UBCOAerospaceClub/LTELink/KiCad/LTELink/images/back-perspective.png

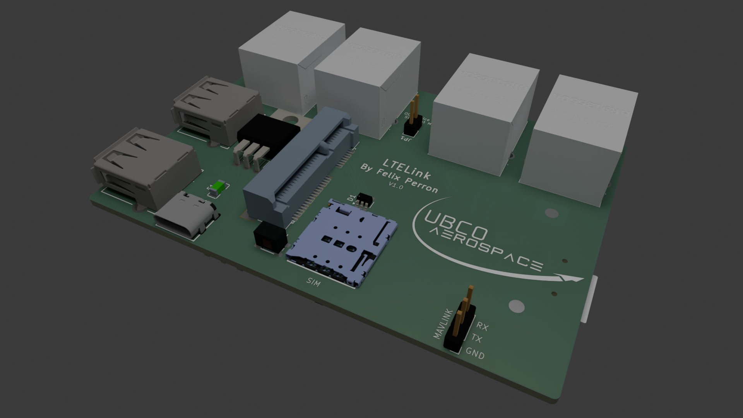
KiCad/LTELink/images/back-perspective.png
