UBCOAerospaceClub/LTELink/KiCad/LTELink/images/back.png

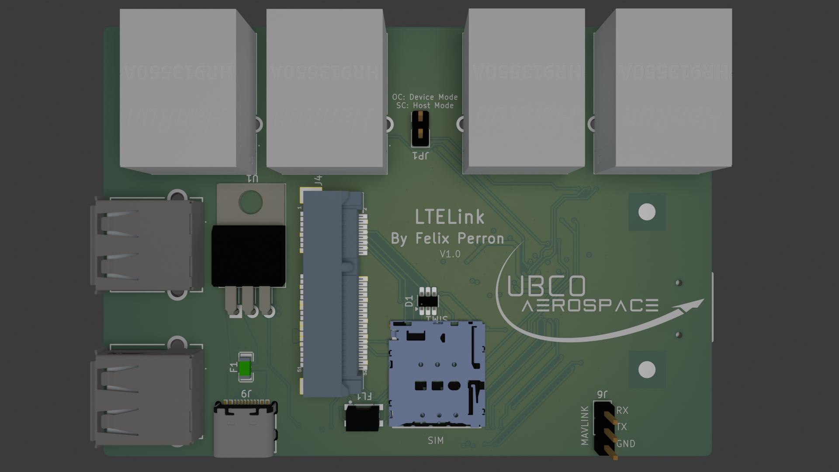
KiCad/LTELink/images/back.png
