UBCOAerospaceClub/LTELink/KiCad/LTELink/images/front-perspective.png

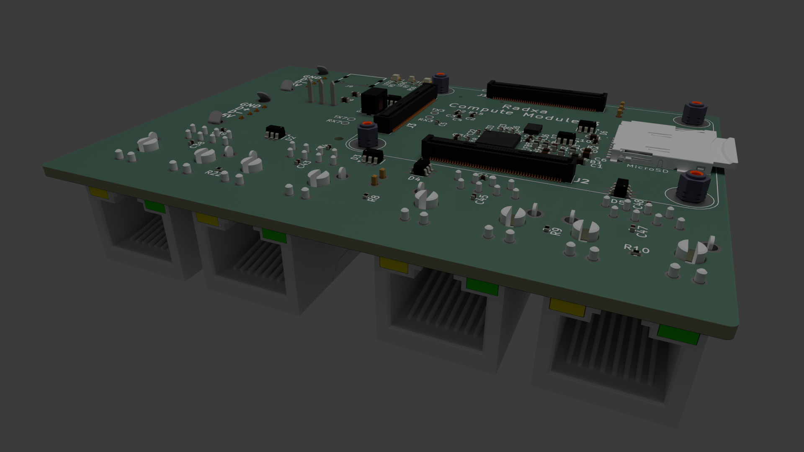
KiCad/LTELink/images/front-perspective.png
