UBCOAerospaceClub/LTELink/KiCad/LTELink/images/front.png

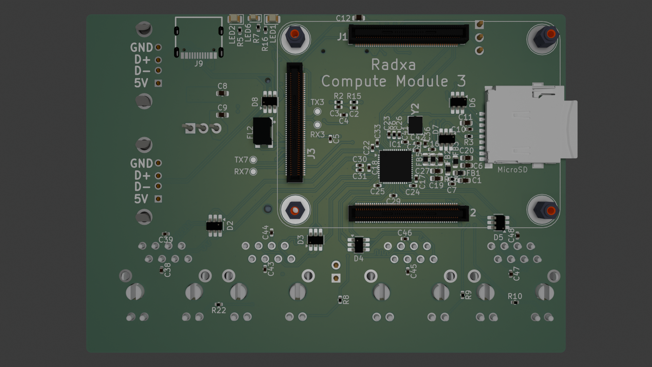
KiCad/LTELink/images/front.png
