UBCOAerospaceClub/LTELink/KiCad/LTELink/images/ports.png

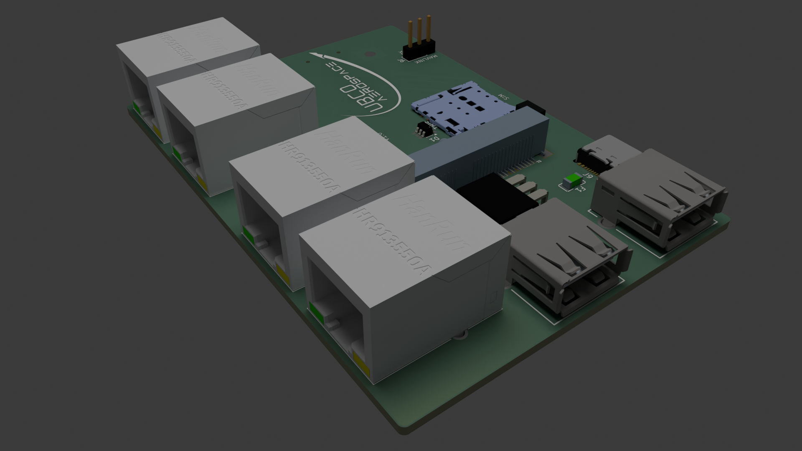
KiCad/LTELink/images/ports.png
