UBCOAerospaceClub/LTELink/KiCad/USB Breakout/production/bom.csv

Designator | Footprint | Quantity | Value | LCSC Part #
J1 | 902131A1011D10100 | 1 | USB_A
J2 | PinHeader_1x04_P2.54mm_Vertical | 1 | Conn_01x04
