UBCOAerospaceClub/LTELink/KiCad/Ethernet Breakout/production/bom.csv

Designator | Footprint | Quantity | Value | LCSC Part #
C2, C3 | 0603 | 2 | 100n | C1525
