UBCOAerospaceClub/LTELink/(list of files, cad)

Other CAD files:
KiCad/LTELink/LTELink.blend
