UBCOAerospaceClub/LTELink/KiCad/Ethernet Breakout/Ethernet Breakout.kicad_pcb

## KiCad design KiCad/Ethernet Breakout/Ethernet Breakout.kicad_pcb (2026-06-09)

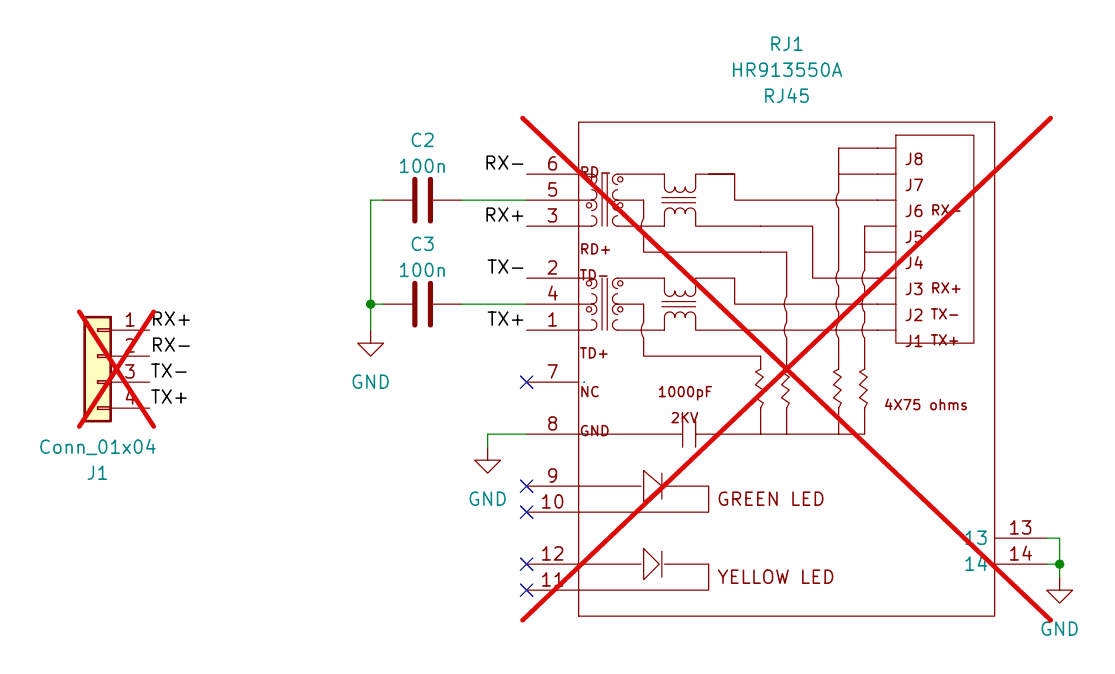
[picture p6: schematic Ethernet Breakout.kicad_sch]

Parts:
C2, C3: 100n; C_0603_1608Metric_Pad1.08x0.95mm_HandSolder; LCSC Part # C1525
J1: Conn_01x04; PinHeader_1x04_P2.54mm_Vertical; not fitted
RJ1: HR913550A; not fitted

Connections:
/RX+: J1.1, RJ1.3
/RX-: J1.2, RJ1.6
/TX+: J1.4, RJ1.1
/TX-: J1.3, RJ1.2
GND: C2.1, C3.1, RJ1.8 (GND), RJ1.13, RJ1.14
unnamed: C2.2, RJ1.5
unnamed: C3.2, RJ1.4

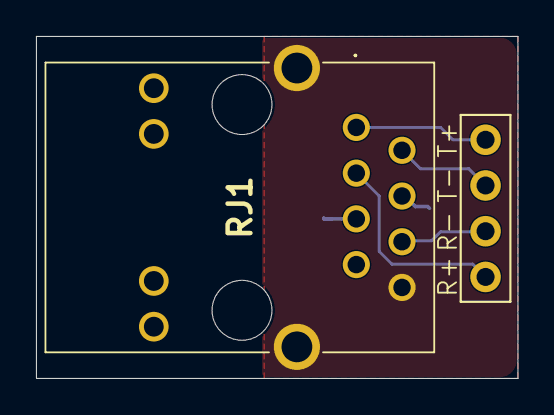
[picture p7: board Ethernet Breakout.kicad_pcb from above]

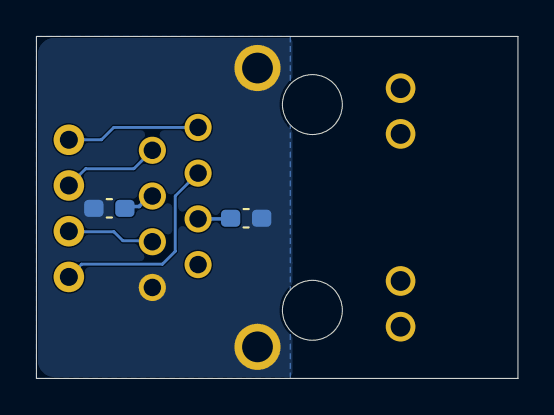
[picture p8: board Ethernet Breakout.kicad_pcb from below]

Board: 2 copper layers, 26.8 x 19.0 mm, 4 parts (2 on the bottom side), 7 nets.
