UBCOAerospaceClub/LTELink/(commit log)

2026-01-07 update current state of project
    [EC25.kicad_sch, LTELink.kicad_sch, compute_module.kicad_sch, ethernet.kicad_sch, sd_card.kicad_sch, uart.kicad_sch, usb.kicad_sch]
2026-01-22 mostly done except for RTL8305 power stuff
    [EC25.kicad_sch, LTELink.kicad_sch, ethernet.kicad_sch, sd_card.kicad_sch, usb.kicad_sch]
2026-01-24 most traces complete. need to connect grounds
    [ethernet.kicad_sch]
2026-01-25 Wiring complete!
2026-01-29 Finally done the layout
    [LTELink.kicad_sch, uart.kicad_sch, usb.kicad_sch]
2026-02-04 Finalized layout, added more detailed 3d models
    [LTELink.blend, LTELink.kicad_pcb, uart.kicad_sch]
2026-02-06 replaced ferrites with 0 omh resitors, finalized standoff solution
    [EC25.kicad_sch, LTELink.kicad_pcb, compute_module.kicad_sch, ethernet.kicad_sch, sd_card.kicad_sch]
2026-02-06 fix ethernet skews
    [LTELink.kicad_pcb]
2026-02-07 finalized board for fabrication
    [EC25.kicad_sch, LTELink.kicad_pcb, LTELink_bom.csv, LTELink_designators.csv, LTELink_positions.csv, compute_module.kicad_sch, ethernet.kicad_sch, sd_card.kicad_sch]
2026-02-11 fix incorrect footprint orientation and breakout uarts
    [EC25.kicad_sch, LTELink.kicad_pcb, LTELink.kicad_sch, compute_module.kicad_sch, uart.kicad_sch, usb.kicad_sch]
2026-03-29 fixed CM3 footprint
    [EC25.kicad_sch, LTELink.kicad_pcb, LTELink.kicad_sch, compute_module.kicad_sch, ethernet.kicad_sch, sd_card.kicad_sch, uart.kicad_sch, usb.kicad_sch]
2026-04-02 Progress on V2.0 and file structure reformat
    [EC25.kicad_sch, LTELink.blend, LTELink.kicad_pcb, LTELink.kicad_sch, LTELink_bom.csv, LTELink_designators.csv, LTELink_positions.csv, compute_module.kicad_sch]
2026-04-02 Add Ethernet Brekaout board
    [Ethernet Breakout.kicad_pcb, Ethernet Breakout.kicad_sch]
2026-04-02 Add USB Breakout board
    [USB Breakout.kicad_pcb, USB Breakout.kicad_sch]
2026-04-12 Moved LEDs to other side of the board, which means they mustbe assembled by hand. Added UART 5 test points.
    [EC25.kicad_sch, LTELink.kicad_pcb, ethernet.kicad_sch, uart.kicad_sch]
2026-06-09 Finalized Ethernet Breakout for production
    [Ethernet Breakout.kicad_pcb, Ethernet Breakout.kicad_sch, bom.csv, designators.csv, positions.csv]
2026-06-09 Finalized USB Breakout for production
    [USB Breakout.kicad_pcb, bom.csv, designators.csv, positions.csv]
2026-06-09 Finalize LTELink V2 for production
    [LTELink.kicad_sch, LTELink_bom.csv, LTELink_designators.csv, LTELink_positions.csv, compute_module.kicad_sch, ethernet.kicad_sch, pwm.kicad_sch, uart.kicad_sch]
